henriheimann/urban-climate-monitor/README.md

# Urban Climate Monitor

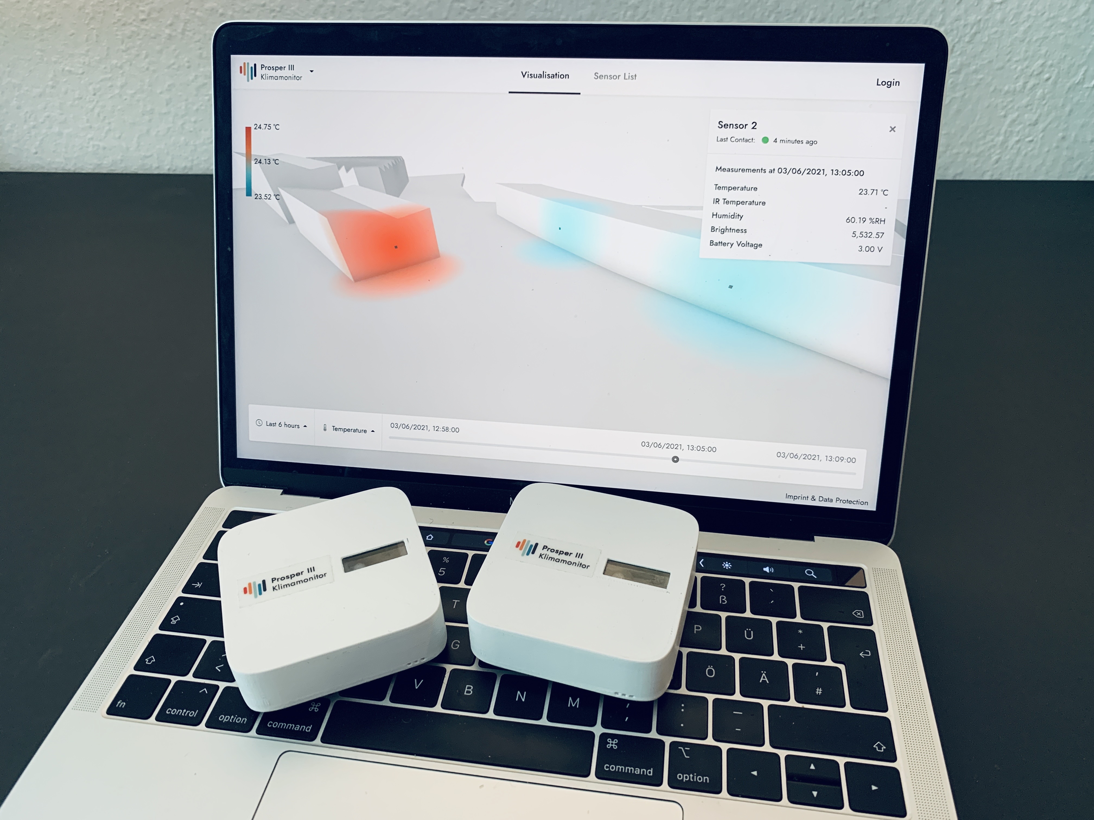
[picture p1: documentation/assets/promo.jpeg]
Promo


Documentation: https://henriheimann.github.io/urban-climate-monitor/
