henriheimann/urban-climate-monitor/documentation/hardware.adoc

=== Schematics

Sensor Node Schematic

=== Bill of Materials

[cols="~,~,~,~"]
|===
|Reference |Value |Manufacturer # |Comment
|AE1 | |ANT-868-CHP-T |Linx 868 Mhz Antenna
|BT1 | |2468 |Keystone 2xAAA battery holder
|C11 |4.7pF | |
|C12 |15pF | |
|C2 C4 C5 C6 C7 C8 C9 C10 C13 C14 C15 C16 |100nF | |
|C1 C3 |10uF | |
|D1 | |BPV10 |Vishay Photodiode
|FB1 | |742792040 |Wurth Elektronik Ferrite Bead
|J1 | |CONUFL001-SMD-T |Linx connector required only for antenna matching
|J2 | |SHF-105-01-L-D-TH |Samtec connector for SWD 2x5 1.27mm
|L1 |4.7uH | |
|Q1 | |PMV250EPEA |Nexpreia P-channel MOSFET
|R11 R12 |4.7k | |
|R13 |100 | |
|R5 R6 R7 R14 |10k | |
|R2 |330k | |
|R3 R4 R10 |100k | |
|R8 |1M | |
|R9 |33k | |
|U1 | |TLV61225DCKR |Texas Instruments voltage regulator
|U2 | |TPS27081ADDCR |Texas Instruments switch for reverse voltage protection
|U3 | |SHT31-DIS-F2.5kS |Sensirion temperature and humidity sensor
|U4 | |24LC32AT-I/SN |Microchip EEPROM
|U5 | |MLX90614ESF-BCC-000-TU |Optional Melexis IR temperature sensor
|U6 | |ADG633YRUZ |Analog Devices CMOS switch
|U7 | |TSV911RILT |STMicroelectronics operational amplifier
|U8 | |RFM95W-868 |HopeRF LoRA module
|U9 | |STM32L412KBT6 |STMicroelectronics microcontroller
| | |CSH-SGFB-100-UFFR |Additional equipment: Linx cable for antenna matching
| | |ADP-SMAM-SMAM-G |Additional equipment: Linx adapter for antenna matching

|===

=== Plots

[.clearfix]
--
[.left]
.Top
Top Plot

[.left]
.Bottom
Bottom Plot
--
