henriheimann/urban-climate-monitor/documentation/quickstart.adoc

=== The Things Network Setup

The system requires a The Things Network application. To do so create a TTN account and use the https://console.cloud.thethings.network/[TTN cloud console]. You will require the region, the id and the EUI of the application later. An access key with read and write privileges must also be generated and noted down. Lastly setup the decoder function for the created TTN application using the following Javascript code:

.TTN Payload Decoder Function
[source,javascript]
----
function decode_int16(byte_high, byte_low) {
  var int16 = ((byte_high << 8) | byte_low);
  if (int16 == 32767) {
    return null;
  } else {
    return int16 / 100.0;
  }
}

function Decoder(bytes, port) {
  var decoded = {};

  decoded.temperature = decode_int16(bytes[1], bytes[0]);
  decoded.humidity = decode_int16(bytes[3], bytes[2]);
  decoded.ir_temperature = decode_int16(bytes[5],  bytes[4]);
  decoded.brightness_current = (bytes[9] << 24) | (bytes[8] << 16) | (bytes[7] << 8) | bytes[6];
  decoded.battery_voltage = bytes[10] / 10.0;

  return decoded;
}
----

=== Development Environment

The setup of the local development environment requires quite a few steps. First and foremost, for Sensor Nodes to be able to actively communicate their measurements to the backend, they require a The Things Network gateway in LoRA communications range. A good gateway for getting started which is available for less than 100€ is the https://www.thethingsnetwork.org/docs/gateways/thethingsindoor/[TTN Indoor Gateway].

==== local-dev Deployment

To start the required services (PostgreSQL database, Telegraf and InfluxDB) to get the backend and frontend up and running use the local-dev deployment stage. Create an `.env` file using the following content, save it as `deployment/local-dev/.env` and execute `deployment/local-dev/deploy-local-dev.sh` afterwards:

.local-dev Deployment Example .env FIle
[source]
----
INFLUXDB_HOST=ucm-influxdb          # Used for inter-container connections, unreachable from host
INFLUXDB_PORT=8086
INFLUXDB_DB=metrics
INFLUXDB_TEST_DB=metricstest
INFLUXDB_ADMIN_USER=admin
INFLUXDB_ADMIN_PASSWORD=password    # For the setup of the local dev environment, use the worst password possible
INFLUXDB_USER=user
INFLUXDB_USER_PASSWORD=password

TELEGRAF_HOST=ucm-telegraf          # Used for inter-container connections, unreachable from host

TTN_REGION=                         # Fill using the values of your TTN app
TTN_APP_ID=                         # Fill using the values of your TTN app
TTN_APP_ACCESS_KEY=                 # Fill using the values of your TTN app

POSTGRES_HOST=::1                   # Used to access from the host machine
POSTGRES_PORT=5432
POSTGRES_USER=user
POSTGRES_PASSWORD=password
POSTGRES_DB=ucm
POSTGRES_TEST_DB=ucmtest
----

==== Backend

Environment variables:: Make sure to export the following environment variables or set them up in your IDE before starting the backend.

[cols="1,~,~"]
|===
|Variable |Value |Description 

|POSTGRES_HOST
|::1
|Host under which the backend can reach the PostgreSQL instance running.

|POSTGRES_PORT
|5432
|Port under which the backend can reach the PostgreSQL instance running.

|POSTGRES_DB
|ucm
|Name of the PostgreSQL database used.

|POSTGRES_USER
|user
|User to access the PostgreSQL database.

|POSTGRES_PASSWORD
|password
|Password to access the PostgreSQL database.

|INFLUXDB_HOST
|localhost
|Host under which the backend can reach the InfluxDB instance running, different from the internal host configured in the .env file!

|INFLUXDB_PORT
|8086
|Port under which the backend can reach the InfluxDB instance running.

|INFLUXDB_DB
|metrics
|Name of the InfluxDB database used.

|INFLUXDB_USER
|user
|User to access the InfluxDB database.

|INFLUXDB_USER_PASSWORD
|password
|Password to access the InfluxDB database.

|UCM_BACKEND_ADMIN_USERNAME
|admin
|The username of the default admin created when starting the backend.

|UCM_BACKEND_ADMIN_PASSWORD
|password
|The password of the default admin created when starting the backend.

|UCM_BACKEND_OAUTH_CLIENT_ID
|ucm-client
|The client used by the frontend when requesting tokens.

|UCM_BACKEND_OAUTH_CLIENT_SECRET
|secret
|The password used by the frontend when requesting tokens.

|TTN_REGION
|
|Region of your TTN app.

|TTN_APP_ID
|
|ID of your TTN app.

|TTN_APP_ACCESS_KEY
|
|Access key of your TTN app.

|TTN_APP_EUI
|
|EUI of your TTN app EUI.

|TTN_DEVICE_ID_PREFIX
|26011
|Different for all regions, for eu use 26011.

|DEPLOYMENT_URL
|http://locahost:4200
|The URL under which the frontend will be run, required for CORS configuration.

|===

Running the backend:: You can use maven to compile and run the backend using `mvn clean install` and `mvn spring-boot:run`.

==== Frontend

Environment variables:: Make sure to export the following environment variables before starting the frontend.

[cols="1,~,~"]
|===
|Variable |Value |Description 

|UCM_BACKEND_URL
|http://localhost:8080
|The url under which the frontend expects the backend.

|UCM_BACKEND_OAUTH_CLIENT_ID
|ucm-client
|The client used when requesting tokens.

|UCM_BACKEND_OAUTH_CLIENT_SECRET
|secret
|The password used when requesting tokens.

|UCM_FRONTEND_PRODUCTION
|false
|Only used to enable production builds.

|===

Running the frontend:: Install the required packages using `npm install` and run the frontend with `npm run start`. It should now accessible using the browser of your choice under http://localhost:4200.

=== Hardware Fabrication

Export Gerber files:: You can use KiCAD to export Geber files under File > Plot. Use the settings required by your manufacturer.
Fabrication:: The existing sensor nodes have been fabricated by https://aisler.net/[Aisler] as 'Beautiful Boards Budget' with a thickness of 1,6mm.
Assembly:: See <<Bill of Materials>> for a detailed list of all parts required for the assembly of a sensor node board. The surface mount components of the existing sensor nodes have been assembled using solder paste and a stencil manufactured also by Aisler. 

=== Embedded Software

Environment variables:: Make sure to export the following environment variables before proceeding. The values for these are unique per Sensor and can be obtained from the administration section of the frontend. For that purpose, create a new or view an existing sensor and click the Keys button under TTN Keys.

[cols="1,~,~"]
|===
|Variable |Example Value |Description 

| TTN_KEYS_DEVICE_ADDRESS
| {0x00, 0x00, 0x00, 0x00}
| Device address of this sensor

| TTN_KEYS_APPLICATION_SESSION_KEY
| {0x00, ..., 0x00}
| Key for accessing TTN, do not share!

| TTN_KEYS_NETWORK_SESSION_KEY
| {0x00, ..., 0x00}
| Key for accessing TTN, do not share!
|===

Prerequisites:: `cmake` and `gcc-arm-none-eabi` are required to build the embedded software.
Go to software directory:: `cd <project root>/software/embedded/sensor-node/`
Create build directory:: `cmake -E make_directory build && cd build`
Run CMake:: `cmake .. -DCMAKE_BUILD_TYPE=Release`
Run CMake build:: `cmake --build . --config Release`
Flash onto hardware:: Use the STM32 ST-Link utility to flash the created binary onto the microcontroller. You will need an ST-Link programmer and an adapter from your programmer to SWD (2x5 1.27mm) (for example https://www.adafruit.com/product/2094[this one] from Adafruit). For the first flashing of a brand new microcontroller, you may need to use ST-Link utility to disable the Option Byte `nBoost0_SW_Cfg`. For later flashings, you can use any other utility such as OpenOCD which can be directly done from your IDE.

=== Assembly

==== Required Parts

[cols="1,~"]
|===
|Count |Part

|1
|Fabricated and assembled Sensor Node PCB

|1
|3d-printed and painted case upper half

|1
|3d-printed and painted case lower half

|1
|Acrylic glass sheet with dimensions 1x3cm and a depth of no more than 1.5mm

|1
|Self-adhesive logo label 

|2
|2x M2 screws with a length of 6mm

|4
|4x M3 screws with a length of 16mm

|2
|2x AAA batteries

|===

.Overview of all Parts
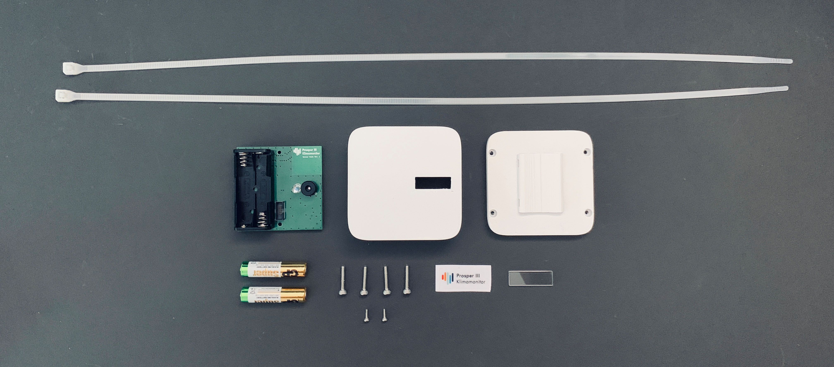
[picture p11: documentation/assets/parts-overview-cable-ties.jpeg]
Parts for Assembly


==== Assembly Steps

Add acrylic glass sheet:: Glue the acrylic glass sheet into the matching cutout of the upper half of the case from the inside.
Add logo:: Apply the self-adhesive logo sticker next to the cutout from the outside.
Mount PCB:: Screw the PCB onto the lower half of the case using the two M2 screws. You will need to apply a lot of pressure to force these into the 3d-printed screw holes.
Insert batteries:: If haven done so already, insert the two AAA batteries into the holder. You should have flashed the firmware and verified that sensor successfully communicates with TTN and the Urban Climate Monitor web solution by now. 
Close the case:: Place the lower half of the case in the upper half of the case and screw them together using the 4 M3 screws.
