henriheimann/urban-climate-monitor/documentation/assets/location_sensor_list.png

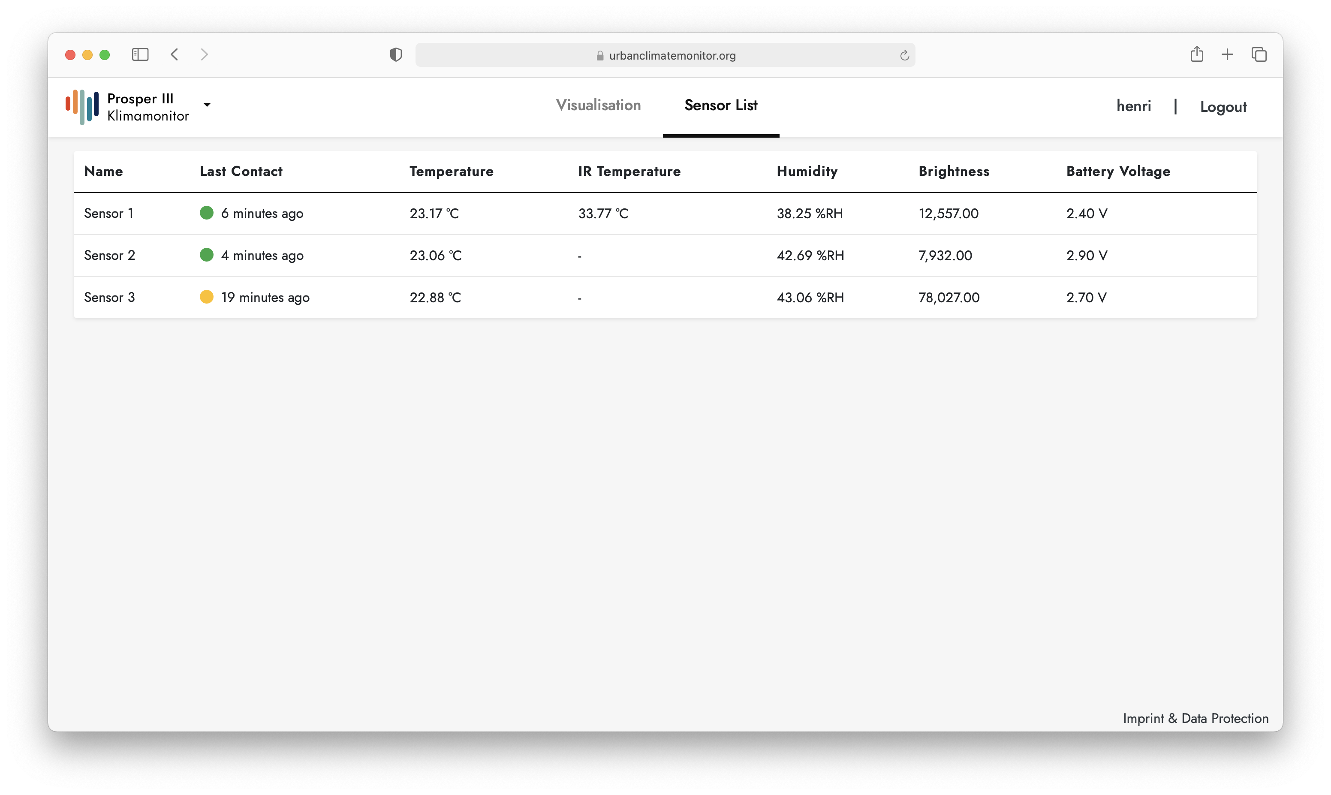
documentation/assets/location_sensor_list.png
