henriheimann/urban-climate-monitor/documentation/assets/three-sensors.jpeg

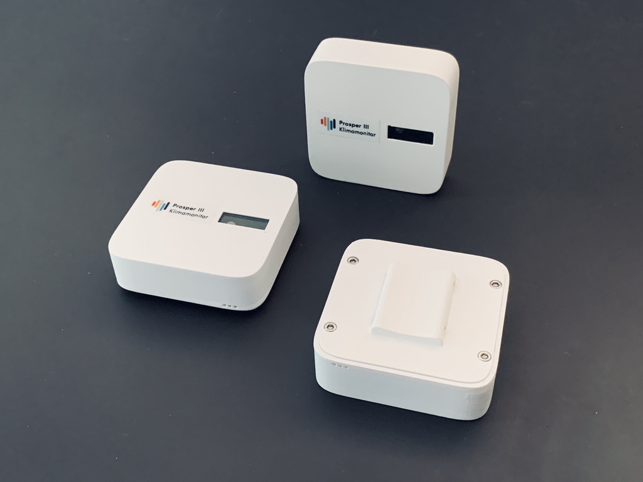
documentation/assets/three-sensors.jpeg
