henriheimann/urban-climate-monitor/hardware/sensor-node/bom.xlsx

 | Number of Boards: | 3
Source | Reference | Value | Quantity Abs | Quantity | Manufacturer # | Digikey # | Digikey STK | Mouser # | Mouser STK | Price
BOM | AE1 |  |  | 1 | ANT-868-CHP-T | ANT-868-CHP-TCT-ND | 2.32 € |  |  | 6.96 €
BOM | BT1 |  |  | 1 | 2468 |  |  | 534-2468 | 1.15 € | 3.45 €
BOM | C11 | 4.7pF |  | 1 | C0805C479C8HACTU |  |  | 80-C0805C479C8HACTU | 0.09 € | 0.26 €
BOM | C12 | 15pF |  | 1 | C0805C150M8HACTU |  |  | 80-C0805C150M8HACTU | 0.09 € | 0.26 €
BOM | C2 C4 C5 C6 C7 C8 C9 C10 C13 C14 C15 C16 | 100nF |  | 12 | C0805C103K8RACTU |  |  | 80-C0805C103K8R | 0.15 € | 5.47 €
BOM | C1 C3 | 10uF |  | 2 | C0805C106K9PAC7210 |  |  | 80-C0805C106K9P7210 | 0.12 € | 0.71 €
BOM | D1 |  |  | 1 | BPV10 |  |  | 782-BPV10 | 0.93 € | 2.80 €
BOM | FB1 |  |  | 1 | 742792040 |  |  | 710-742792040 | 0.19 € | 0.56 €
BOM | J1 |  |  | 1 | CONUFL001-SMD-T |  |  | 712-CONUFL001-SMD-T | 0.53 € | 1.58 €
BOM | J2 |  |  | 1 | SHF-105-01-L-D-TH |  |  | 200-SHF10501LDTH | 2.29 € | 6.87 €
BOM | L1 | 4.7uH |  | 1 | SRN4018TA-4R7M | SRN4018TA-4R7MCT-ND | 0.41 € |  |  | 1.23 €
BOM | Q1 |  |  | 1 | PMV250EPEA |  |  | 771-PMV250EPEAR | 0.34 € | 1.02 €
BOM | R11 R12 | 4.7k |  | 2 | RC0805FR-074K7L |  |  | 603-RC0805FR-074K7L | 0.11 € | 0.66 €
BOM | R13 | 100 |  | 1 | RC0805FR-07100RL |  |  | 603-RC0805FR-07100RL | 0.11 € | 0.33 €
BOM | R5 R6 R7 R14 | 10k |  | 4 | RC0805FR-0710KL |  |  | 603-RC0805FR-0710KL | 0.11 € | 1.32 €
BOM | R2 | 330k |  | 1 | RC0805FR-07330KL |  |  | 603-RC0805FR-07330KL | 0.11 € | 0.33 €
BOM | R3 R4 R10 | 100k |  | 3 | RC0805FR-07100KL |  |  | 603-RC0805FR-07100KL | 0.11 € | 0.99 €
BOM | R8 | 1M |  | 1 | RC0805FR-071ML |  |  | 603-RC0805FR-071ML | 0.09 € | 0.26 €
BOM | R9 | 33k |  | 1 | RC0805FR-0733KL |  |  | 603-RC0805FR-0733KL | 0.11 € | 0.33 €
BOM | U1 |  |  | 1 | TLV61225DCKR |  |  | 595-TLV61225DCKR | 0.86 € | 2.58 €
BOM | U2 |  |  | 1 | TPS27081ADDCR |  |  | 595-TPS27081ADDCR | 0.66 € | 1.98 €
BOM | U3 |  |  | 1 | SHT31-DIS-F2.5kS |  |  | 403-SHT31-DIS-F | 5.40 € | 16.20 €
BOM | U4 |  |  | 1 | 24LC32AT-I/SN |  |  | 579-24LC32AT-I/SN | 0.29 € | 0.86 €
BOM | U5 |  |  | 1 | MLX90614ESF-BCC-000-TU | MLX90614ESF-BCC-000-TU-ND | 20.78 € |  |  | 62.34 €
BOM | U6 |  |  | 1 | ADG633YRUZ |  |  | 584-ADG633YRUZ | 2.24 € | 6.72 €
BOM | U7 |  |  | 1 | TSV911RILT |  |  | 511-TSV911RILT | 0.63 € | 1.89 €
BOM | U8 |  |  | 1 | RFM95W-868 | RFM95W-868S2-ND | 12.20 € |  |  | 36.60 €
BOM | U9 |  |  | 1 | STM32L412KBT6 |  |  | 511-STM32L412KBT6 | 3.06 € | 9.18 €
EQUIP |  |  | 1 |  | CSH-SGFB-100-UFFR |  |  | 712-CSH-SGFB100-UFFR | 4.87 € | 4.87 €
EQUIP |  |  | 1 |  | ADP-SMAM-SMAM-G |  |  | 712-ADP-SMAM-SMAM-G | 5.52 € | 5.52 €
 |  |  |  |  |  |  |  |  |  | 184.11 €
