henriheimann/urban-climate-monitor/documentation/assets/parts-overview.jpeg

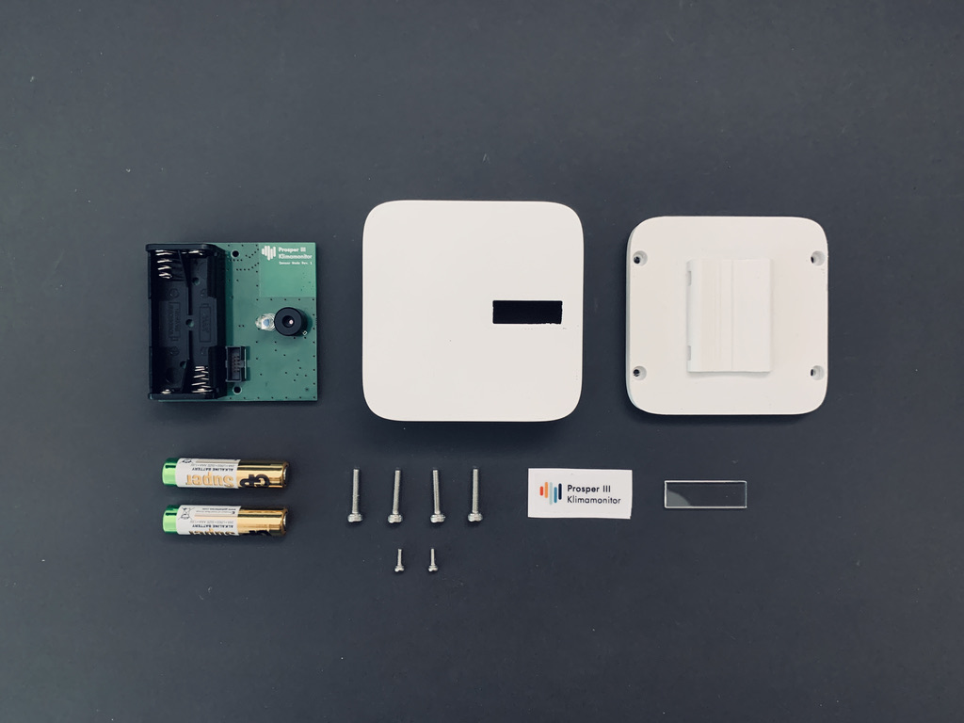
documentation/assets/parts-overview.jpeg
