henriheimann/urban-climate-monitor/design/prosperIII.obj

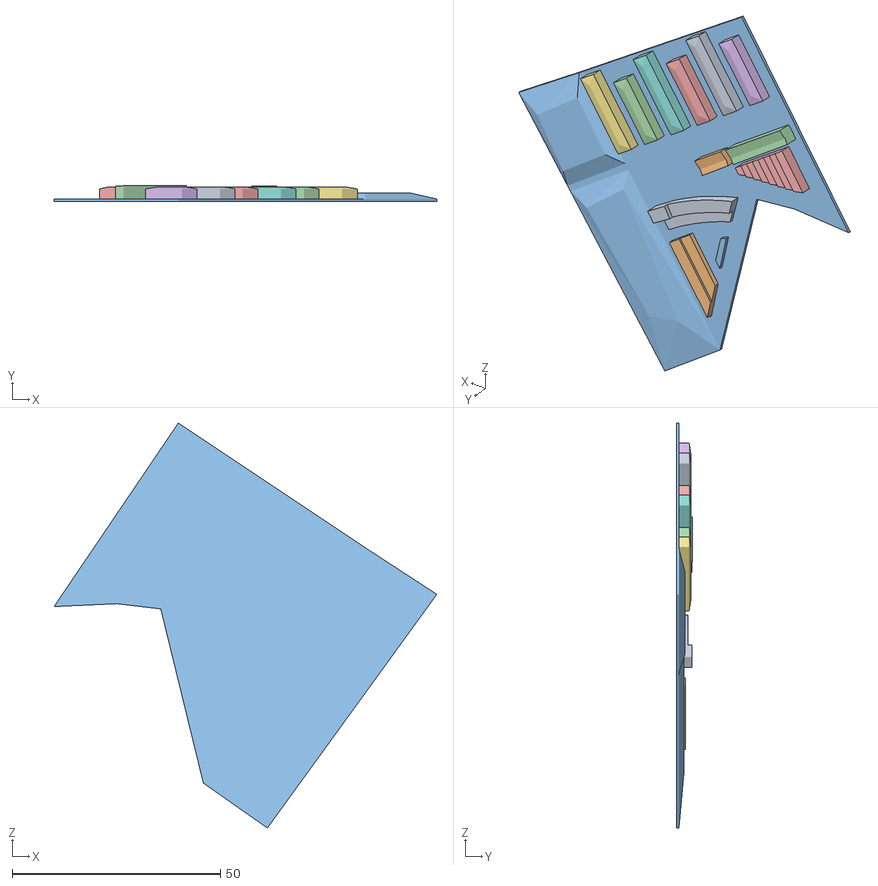
[picture p15: CAD file, 2021-05-31]
design/prosperIII.obj
92.0 x 3.91 x 97.3
Cube_Cube.001
Cube.001_Cube.002
Cube.002_Cube.003
Cube.003_Cube.004
Cube.004_Cube.005
Cube.005_Cube.006
Cube.006_Cube.008
Cube.007_Cube.009
Cube.008_Cube.010
Cube.009_Cube.011
Cube.010_Cube.012
Cube.011_Cube.013
Cube.012_Cube.014
