henriheimann/urban-climate-monitor/software/backend/src/test/resources/uploads/models/cube.obj

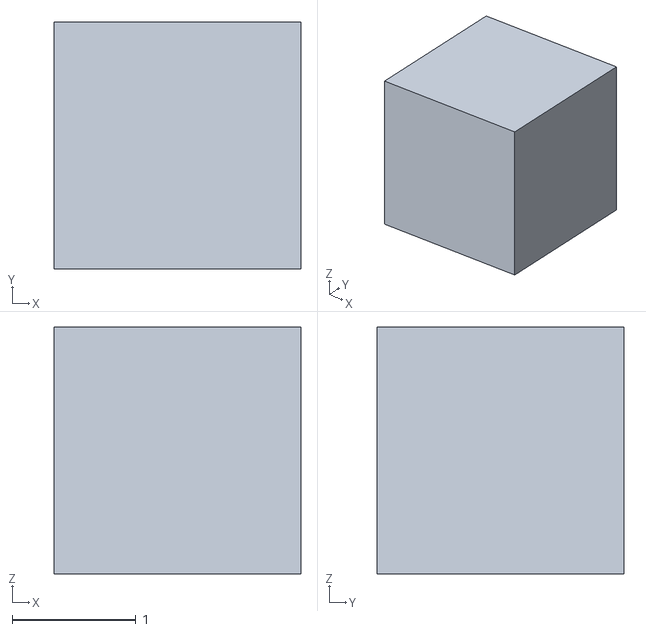
[picture p16: CAD file, 2021-04-15]
software/backend/src/test/resources/uploads/models/cube.obj
2.00 x 2.00 x 2.00
