henriheimann/urban-climate-monitor/(list of files, cad)

Other CAD files:
software/backend/src/test/resources/uploads/models/cube2.obj
design/prosperIII.blend
