henriheimann/urban-climate-monitor/design/logo-print.pdf

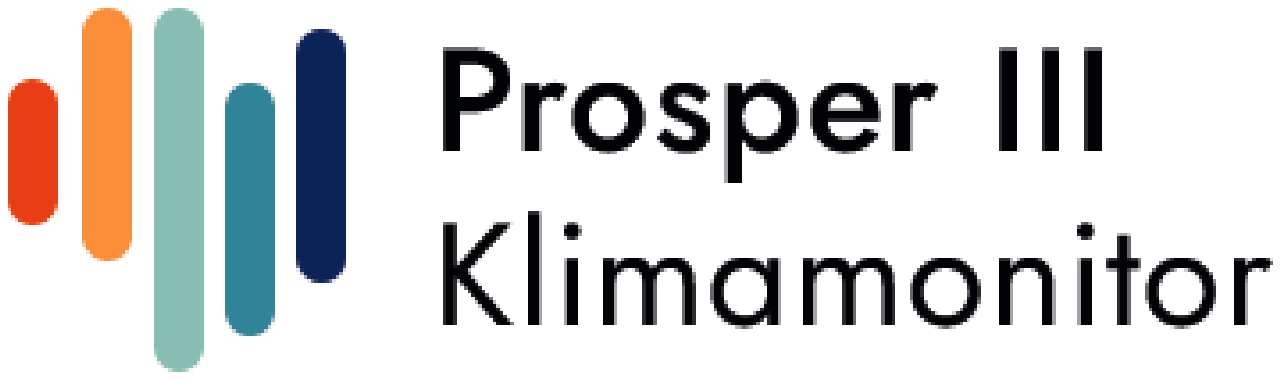
[picture p17: page 1]
