henriheimann/urban-climate-monitor/hardware/sensor-node/sensor-node.kicad_pcb

## KiCad design hardware/sensor-node/sensor-node.kicad_pcb (2021-04-15)

Schematic: sensor-node.sch, Urban Climate Monitor Sensor Node

Parts:
AE1: ANT-868-CHP-T; Linx_ANT-868-CHP-T; mouser# 712-ANT-868-CHP-T; digikey# ANT-868-CHP-TCT-ND
BT1: Keystone-2468; BatteryHolder_Keystone_2468_2xAAA_NoSilkscreen; mouser# 534-2468; digikey# 36-2468-ND
C1, C3: 10uF; C_0805_2012Metric_Pad1.18x1.45mm_HandSolder; mouser# 80-C0805C106K9P7210; digikey# 399-C0805C106K9PAC7210CT-ND
C2, C4, C5, C6, C7, C8, C9, C10, C13, C14, C15, C16: 100nF; C_0805_2012Metric_Pad1.18x1.45mm_HandSolder; mouser# 80-C0805C103K8R; digikey# C0805C103K8RAC7800
C11: 4.7pF; C_0805_2012Metric_Pad1.18x1.45mm_HandSolder; mouser# 80-C0805C479C8HACTU; digikey# C0805C479C8HAC7800-ND
C12: 15pF; C_0805_2012Metric_Pad1.18x1.45mm_HandSolder; mouser# 80-C0805C150M8HACTU; digikey# C0805C150M8HAC7800
D1: BPV10; LED_D5.0mm_Clear; mouser# 782-BPV10; digikey# 751-1001-ND
FB1: WE742792040; L_0805_2012Metric_Pad1.15x1.40mm_HandSolder; mouser# 710-742792040; digikey# 732-1620-1-ND
H1, H2: MountingHole; MountingHole_2.2mm_M2
J1: CONUFL001-SMD-T; CONUFL001-SMD; mouser# 712-CONUFL001-SMD-T; digikey# CONUFL001-SMD-TCT-ND
J2: SHF-105-01-L-D-TH; mouser# 200-SHF10501LDTH; digikey# SAM11769-ND
L1: 4.7uH; L_Bourns-SRN4018_With3DModel; mouser# 652-SRN4018TA-4R7M; digikey# SRN4018TA-4R7MTR-ND
Q1: PMV250EPEA; SOT-23; mouser# 771-PMV250EPEAR; digikey# 1727-2303-1-ND
R1, R6: 100k; R_0805_2012Metric_Pad1.20x1.40mm_HandSolder; mouser# 603-RC0805FR-0710KL; digikey# 311-10.0KCRCT-ND
R2: 330k; R_0805_2012Metric_Pad1.20x1.40mm_HandSolder; mouser# 603-RC0805FR-07330KL; digikey# 311-330KCRCT-ND
R3, R10: 100k; R_0805_2012Metric_Pad1.20x1.40mm_HandSolder; mouser# 603-RC0805FR-07100KL; digikey# 311-100KCRCT-ND
R5, R7, R14: 10k; R_0805_2012Metric_Pad1.20x1.40mm_HandSolder; mouser# 603-RC0805FR-0710KL; digikey# 311-10.0KCRCT-ND
R8: 1M; R_0805_2012Metric_Pad1.20x1.40mm_HandSolder; mouser# 603-RC0805FR-071ML; digikey# 311-1.00MCRCT-ND
R9: 33k; R_0805_2012Metric_Pad1.20x1.40mm_HandSolder; mouser# 603-RC0805FR-0733KL; digikey# 311-33.0KCRCT-ND
R11, R12: 4.7k; R_0805_2012Metric_Pad1.20x1.40mm_HandSolder; mouser# 603-RC0805FR-074K7L; digikey# 311-4.70KCRCT-ND
R13: 100; R_0805_2012Metric_Pad1.15x1.40mm_HandSolder; mouser# 603-RC0805FR-07100RL; digikey# 311-100CRCT-ND
U1: TLV61225; SC-70-6; mouser# 595-TLV61225DCKR; digikey# 296-36756-1-ND
U2: TPS27081A; TSOT-23-6; mouser# 595-TPS27081ADDCR; digikey# 296-34970-1-ND
U3: SHT31-DIS; Sensirion_DFN-8-1EP_2.5x2.5mm_P0.5mm_EP1.1x1.7mm; mouser# 403-SHT31-DIS-F; digikey# 1649-1066-1-ND
U4: 24LC32; SOIC-8_3.9x4.9mm_P1.27mm; mouser# 579-24LC32AT-I/SN; digikey# 24LC32AT-I/SNCT-ND
U5: MLX90614; TO-39-4; mouser# 482-90614ESFBCC000TU; digikey# MLX90614ESF-BCC-000-TU-ND
U6: ADG633YRU; TSSOP-16_4.4x5mm_P0.65mm; mouser# 584-ADG633YRUZ; digikey# ADG633YRUZ-ND
U7: TSV911RILT; SOT-23-5; mouser# 511-TSV911RILT; digikey# 497-10538-1-ND
U8: RFM95W; mouser# 223-RFM95W-868S2; digikey# RFM95W-868S2-ND
U9: STM32L412KB; LQFP-32_7x7mm_P0.8mm; mouser# 511-STM32L412KBT6; digikey# 497-18229-ND
Z1, Z2, Z3: Z; R_0805_2012Metric_Pad1.20x1.40mm_HandSolder

Connections:
+3.3VA: C13.1, FB1.2, U9.5 (VDDA)
+3V3: C1.1, C8.1, C10.1, C14.1, C15.1, FB1.1, J2.1 (VTref), Q1.2 (S), R3.1, R10.2, U1.2 (FB), U1.4 (VOUT), U6.14, U6.16, U8.13 (VCC), U9.1 (VDD), U9.17 (VDD)
/PHOTO_VCC: C6.1, R2.2, U6.13, U7.2 (V+)
GND: BT1.2 (-), C1.2, C2.2, C3.2, C4.2, C5.2, C6.2, C7.2, C8.2, C9.2, C10.2, C13.2, C14.2, C15.2, C16.2, D1.2 (A), J1.2 (Ext), J2.3 (GND), J2.5 (GND), J2.9 (GNDDetect), R1.1, R6.1, R7.1, R14.2, U1.3 (GND), U2.1 (R2), U2.5 (ON/OFF), U2.6 (R1,C1), U3.2 (ADDR), U3.7 (R), U3.8 (VSS), U3.9 (VSS), U4.1 (A0), U4.2 (A1), U4.3 (A2), U4.4 (GND), U4.7 (WP), U5.4 (VSS), U6.6, U6.7, U6.8, U7.5 (V-), U8.1 (GND), U8.8 (GND), U8.10 (GND), U9.16 (VSS), U9.32 (VSS), Z1.2, Z3.1
I2C_ENABLE: Q1.1 (G), R10.1, U9.28 (PB5)
MISO: U8.2 (MISO), U9.12 (PA6)
MOSI: U8.3 (MOSI), U9.13 (PA7)
NRST: C16.1, J2.10 (~RESET~), U9.4 (NRST)
unnamed: AE1.1, Z2.2, Z3.2
unnamed: BT1.1 (+), U2.2 (VOUT), U2.3 (VOUT)
unnamed: C7.1, R2.1, R7.2, U7.3 (+)
unnamed: C11.1, C12.1, D1.1 (K), R8.1, R9.1, U7.4 (-)
unnamed: C11.2, R8.2, U6.2, U6.5
unnamed: C12.2, R9.2, U6.1, U6.3
unnamed: J1.1 (In), U8.9 (ANT), Z1.1, Z2.1
unnamed: L1.1, U1.5 (L)
unnamed: R5.2, U6.4
unnamed: R13.2, U9.6 (PA0)
unnamed: R14.1, U9.31 (PH3)
unnamed: U6.15, U7.1
PHOTO_ENABLE: R6.2, U6.11, U9.21 (PA11)
PHOTO_SENSE: C9.1, R5.1, U9.15 (PB1)
PHOTO_SWITCH: R1.2, U6.9, U6.10, U9.22 (PA12)
RFM95_DIO5: U8.7 (DIO5), U9.8 (PA2)
RFM95_IRQ: U8.14 (DIO0), U9.14 (PB0)
RFM95_NRST: R3.2, U8.6 (RESET), U9.9 (PA3)
RFM95_NSS: U8.5 (~SS), U9.10 (PA4)
SCK: U8.4 (SCK), U9.11 (PA5)
SCL: R11.2, U3.4 (SCL), U4.6 (SCL), U5.1 (SCL), U9.29 (PB6)
SDA: R12.2, U3.1 (SDA), U4.5 (SDA), U5.2 (SDA), U9.30 (PB7)
SWCLK: J2.4 (SWDCLK/TCK), U9.24 (PA14)
SWDIO: J2.2 (SWDIO/TMS), U9.23 (PA13)
VI2C: C2.1, C4.1, C5.1, Q1.3 (D), R11.1, R12.1, U3.5 (VDD), U4.8 (VCC), U5.3 (VDD)
VIN_SENSE: C3.1, L1.2, R13.1, U1.1 (VIN), U1.6 (EN), U2.4 (VIN)

Notes on the sheet:
Reverse Polarity Protection
Boost Converter
SWD Connector
STM32L4 MCU
I2C-Address: 0x44
I2C-Address: 0x5a
Offset: 3.3V*1/(33+1)=97mV
Infrared Temperature Sensor (optional)
Temperature / Humidity Sensor
LoRA Module
Light Sensor
I2C-Address: 0x50
EEPROM
5000nA Sleep
200nA Sleep
5000nA Standby
245nA Standby with RTC
10nA when disabled
160Hz low pass
I2C Bus Control

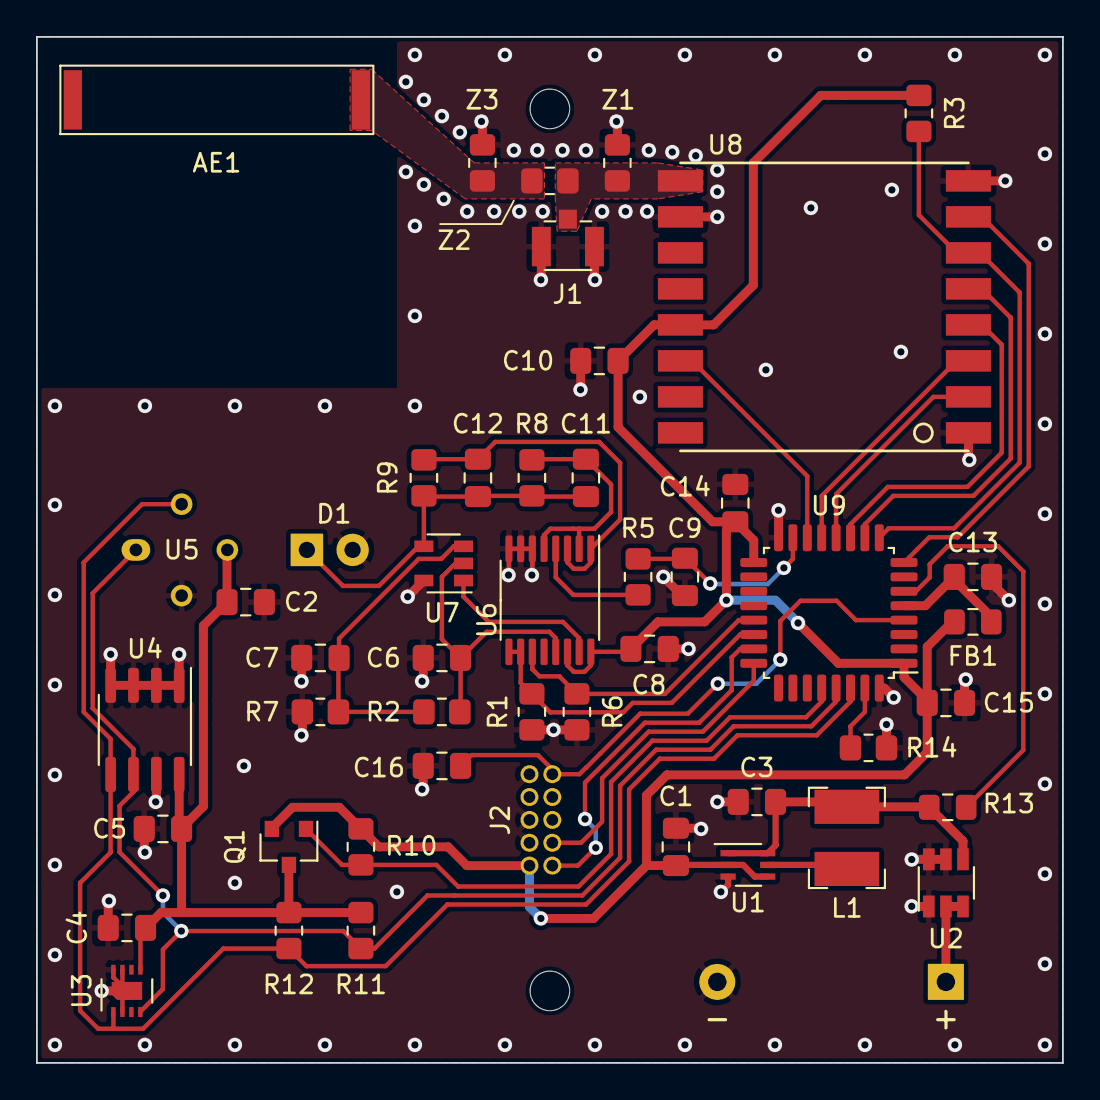
[picture p18: board sensor-node.kicad_pcb from above]

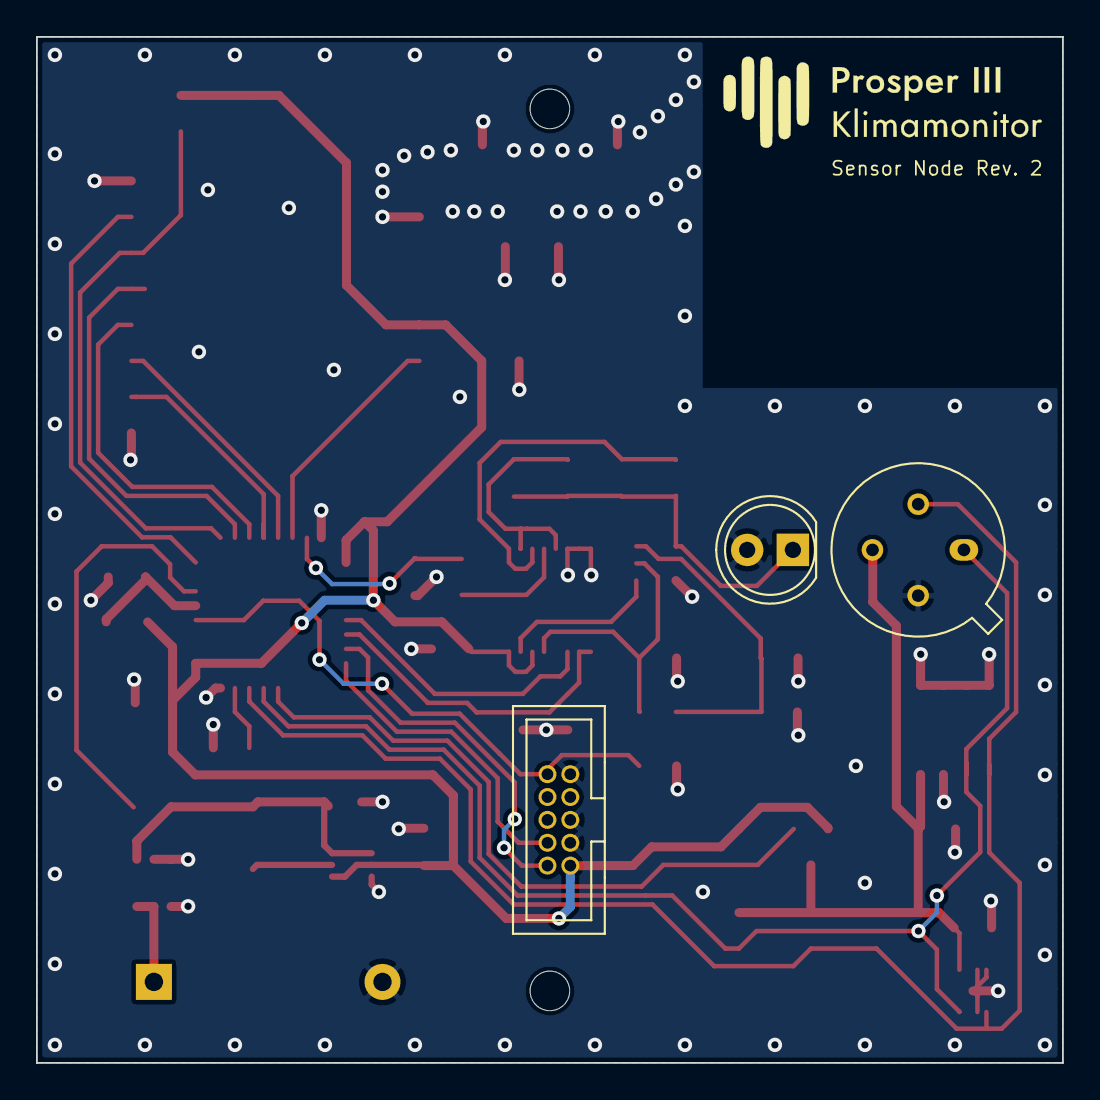
[picture p19: board sensor-node.kicad_pcb from below]

Board: 2 copper layers, 57.0 x 57.0 mm, 51 parts (4 on the bottom side), 34 nets.
