henriheimann/urban-climate-monitor/Hardware/SensorNode/urban-climate-monitor.sch

## KiCad design Hardware/SensorNode/urban-climate-monitor.sch (2020-11-11)

Schematic: urban-climate-monitor.sch

Parts:
AE1: Antenna; 868MHZ_TI_DNO24
BT1: Battery; BatteryHolder_Keystone_2468_2xAAA_NoSilkscreen
C1, C3: 4.7uF; C_0805_2012Metric_Pad1.18x1.45mm_HandSolder
C2, C4, C5, C6, C7, C8, C9, C10, C13, C14, C15, C16: 100nF; C_0805_2012Metric_Pad1.18x1.45mm_HandSolder
C11: 4.7pF; C_0805_2012Metric_Pad1.18x1.45mm_HandSolder
C12: 15pF; C_0805_2012Metric_Pad1.18x1.45mm_HandSolder
D1: D_Photo; LED_D5.0mm_Clear
FB1: Ferrite_Bead_Small; L_0805_2012Metric_Pad1.05x1.20mm_HandSolder
H1, H2: MountingHole; MountingHole_2.2mm_M2
J1: Conn_ARM_JTAG_SWD_10; Amphenol_FCI_ShroudedSocket_2x05_P1.27mm_Vertical_SMD
L1: 4.7uH; L_Bourns-SRN4018_With3DModel
R1, R8: 1M; R_0805_2012Metric_Pad1.20x1.40mm_HandSolder
R2: 330k; R_0805_2012Metric_Pad1.20x1.40mm_HandSolder
R3, R4: 100k; R_0805_2012Metric_Pad1.20x1.40mm_HandSolder
R5, R6, R7, R12: 10k; R_0805_2012Metric_Pad1.20x1.40mm_HandSolder
R9: 33k; R_0805_2012Metric_Pad1.20x1.40mm_HandSolder
R10, R11: 4.7k; R_0805_2012Metric_Pad1.20x1.40mm_HandSolder
U1: AAT1217; TSOT-23-6_HandSoldering
U2: TPS27081A; TSOT-23-6_HandSoldering
U3: SHT31-DIS; Sensirion_DFN-8-1EP_2.5x2.5mm_P0.5mm_EP1.1x1.7mm
U4: 24LC32; SOIC-8_3.9x4.9mm_P1.27mm
U5: TSD305
U6: ADG633YCP; TSSOP-16_4.4x5mm_P0.65mm
U7: TSV911RILT; SOT-23-5
U8: RFM95W
U9: STM32L412KB; LQFP-32_7x7mm_P0.8mm
Z1, Z2, Z3: Z; R_0805_2012Metric_Pad1.20x1.40mm_HandSolder

Notes on the sheet:
Reverse Polarity Protection
Boost Converter
SWD Connector
STM32L4 MCU
I2C-Address: 0x44
I2C-Address: 0x00
Offset: 3.3V*1/(33+1)=97mV
Infrared Temperature Sensor (optional)
Temperature / Humidity Sensor
LoRA Module
Light Sensor
I2C-Address: 0x50
EEPROM
20nA Sleep
200nA Sleep
10nA Standby
245nA Standby with RTC
10nA when disabled
160Hz low pass
