henriheimann/urban-climate-monitor/software/embedded/Core/Src/main.c

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
/* Includes ------------------------------------------------------------------*/
#include "main.h"
#include "adc.h"
#include "i2c.h"
#include "rtc.h"
#include "spi.h"
#include "gpio.h"

/* USER CODE BEGIN Includes */
#include "application.h"
/* USER CODE END Includes */


void SystemClock_Config(void);
/**
  * @brief  The application entry point.
  * @retval int
  */
int main(void)
{
  /* MCU Configuration--------------------------------------------------------*/

  /* Reset of all peripherals, Initializes the Flash interface and the Systick. */
  HAL_Init();

  /* Configure the system clock */
  SystemClock_Config();

  /* USER CODE BEGIN SysInit */
  // Check and handle if the system was resumed from StandBy mode */
  if(__HAL_PWR_GET_FLAG(PWR_FLAG_SB) != RESET)
  {
  	// Clear Standby flag
  	__HAL_PWR_CLEAR_FLAG(PWR_FLAG_SB);
  }
  /* USER CODE END SysInit */

  /* Initialize all configured peripherals */
  MX_GPIO_Init();
  MX_I2C1_Init();
  MX_ADC1_Init();
  MX_RTC_Init();
  MX_SPI1_Init();
  /* USER CODE BEGIN 2 */

  application_main();

  HAL_PWREx_EnableGPIOPullDown(PWR_GPIO_A, PWR_GPIO_BIT_12); // PHOTO_SWITCH
  HAL_PWREx_EnableGPIOPullDown(PWR_GPIO_A, PWR_GPIO_BIT_7); // MOSI
  HAL_PWREx_EnableGPIOPullDown(PWR_GPIO_A, PWR_GPIO_BIT_5); // SCK
  HAL_PWREx_EnableGPIOPullUp(PWR_GPIO_A, PWR_GPIO_BIT_3); // NRST
  HAL_PWREx_EnableGPIOPullDown(PWR_GPIO_A, PWR_GPIO_BIT_4); // NSS
  HAL_PWREx_EnablePullUpPullDownConfig();
  HAL_PWREx_DisableSRAM2ContentRetention();
  HAL_PWREx_EnableBORPVD_ULP();

  // Disable all used wakeup sources
  HAL_RTCEx_DeactivateWakeUpTimer(&hrtc);

  // Clear all related wakeup flags
  __HAL_PWR_CLEAR_FLAG(PWR_FLAG_WU);

  // Setting the Wake up time 1s * 0x0E10 = 1h
  // 10min = 0x0258
  // 10 sec = 0x000a
  HAL_RTCEx_SetWakeUpTimer_IT(&hrtc, 0x0258, RTC_WAKEUPCLOCK_CK_SPRE_16BITS, 0);

  // Enter the Standby mode
  HAL_PWR_EnterSTANDBYMode();

  /* USER CODE END 2 */

  /* Infinite loop */
  /* USER CODE BEGIN WHILE */
  while (1)
  {
    /* USER CODE END WHILE */

    /* USER CODE BEGIN 3 */
  }
  /* USER CODE END 3 */
}

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
