henriheimann/urban-climate-monitor/software/embedded/Core/Inc/main.h

#define VIN_SENSE_Pin GPIO_PIN_0
#define VIN_SENSE_GPIO_Port GPIOA
#define RFM95_DIO5_Pin GPIO_PIN_2
#define RFM95_DIO5_GPIO_Port GPIOA
#define RFM95_NRST_Pin GPIO_PIN_3
#define RFM95_NRST_GPIO_Port GPIOA
#define RFM95_NSS_Pin GPIO_PIN_4
#define RFM95_NSS_GPIO_Port GPIOA
#define RFM95_DIO0_Pin GPIO_PIN_0
#define RFM95_DIO0_GPIO_Port GPIOB
#define PHOTO_SENSE_Pin GPIO_PIN_1
#define PHOTO_SENSE_GPIO_Port GPIOB
#define PHOTO_ENABLE_Pin GPIO_PIN_11
#define PHOTO_ENABLE_GPIO_Port GPIOA
#define PHOTO_SWITCH_Pin GPIO_PIN_12
#define PHOTO_SWITCH_GPIO_Port GPIOA
#define SWDIO_Pin GPIO_PIN_13
#define SWDIO_GPIO_Port GPIOA
#define SWCLK_Pin GPIO_PIN_14
#define SWCLK_GPIO_Port GPIOA
#define I2C_ENABLE_Pin GPIO_PIN_5
#define I2C_ENABLE_GPIO_Port GPIOB
