henriheimann/urban-climate-monitor/software/backend/src/main/java/org/urbanclimatemonitor/backend/security/WebSecurityConfiguration.java

package org.urbanclimatemonitor.backend.security;

import org.springframework.context.annotation.Bean;
import org.springframework.context.annotation.Configuration;
import org.springframework.security.authentication.AuthenticationManager;
import org.springframework.security.authentication.AuthenticationProvider;
import org.springframework.security.authentication.dao.DaoAuthenticationProvider;
import org.springframework.security.config.annotation.web.configuration.EnableWebSecurity;
import org.springframework.security.config.annotation.web.configuration.WebSecurityConfigurerAdapter;
import org.springframework.security.core.userdetails.UserDetailsService;
import org.springframework.security.crypto.bcrypt.BCryptPasswordEncoder;
import org.springframework.security.crypto.password.PasswordEncoder;

@Configuration
@EnableWebSecurity
public class WebSecurityConfiguration extends WebSecurityConfigurerAdapter
{
	private final UserDetailsService userDetailsService;

	public WebSecurityConfiguration(CustomUserDetailsService userDetailsService)
	{
		this.userDetailsService = userDetailsService;
	}

	@Bean
	public AuthenticationProvider authenticationProvider()
	{
		DaoAuthenticationProvider provider = new DaoAuthenticationProvider();
		provider.setPasswordEncoder(passwordEncoder());
		provider.setUserDetailsService(userDetailsService);
		return provider;
	}

	@Bean
	public PasswordEncoder passwordEncoder()
	{
		return new BCryptPasswordEncoder();
	}

	@Bean
	@Override
	public AuthenticationManager authenticationManagerBean() throws Exception
	{
		return super.authenticationManagerBean();
	}
}
