henriheimann/urban-climate-monitor/(commit log)

2020-10-19 Add initial embedded software version and update schematic
    [urban-climate-monitor.kicad_pcb, urban-climate-monitor.sch]
2020-10-23 Update prototype pin assignment
    [urban-climate-monitor.sch]
2020-10-23 Add required submodules to prototype project
2020-10-26 Remove rfm9x submodule, sht3x test in main application
    [urban-climate-monitor.sch]
2020-10-26 Rename prototype project to PrototypeNode
2020-10-30 Add lora frame couting via eeprom
2020-10-30 Include EEPROM in schematic
    [urban-climate-monitor.sch]
2020-10-30 Add photo sensing implementation
    [urban-climate-monitor.sch]
2020-11-02 Create first revision of PCB, add CubeMX project for PCB sensor node
    [urban-climate-monitor.kicad_pcb, urban-climate-monitor.sch]
2020-11-02 Update directory structure
    [urban-climate-monitor.kicad_pcb, urban-climate-monitor.sch]
2020-11-03 Test KiCad action docs generation
2020-11-03 Trigger pipeline
    [urban-climate-monitor.sch]
2020-11-03 Fix warnings of electrical rules check
    [urban-climate-monitor.kicad_pcb, urban-climate-monitor.sch]
2020-11-11 Add photo enable pin, add deployment compose
    [urban-climate-monitor.kicad_pcb, urban-climate-monitor.sch]
2020-11-11 Upload only pdfs as artifact
    [urban-climate-monitor.kicad_pcb, urban-climate-monitor.sch]
2020-11-15 Change folder layout, add new version pcb layout
    [sensor-node.kicad_pcb, sensor-node.sch, urban-climate-monitor.kicad_pcb]
2020-11-15 Fix folder capitalisation
    [sensor-node.kicad_pcb, sensor-node.sch]
2020-11-15 Try fix folder capitalisation again part 1
    [application.c, application.h, main.c, main.h]
2020-11-15 Try fix folder capitalisation again part 2
    [application.c, application.h, main.c, main.h]
2020-11-15 Try fix submodules part 1
    [application.c, application.h, main.c, main.h]
2020-11-19 Update schema to include I2C voltage switching
    [sensor-node.sch]
2020-11-19 Update PCB, add debugging printouts to application
    [sensor-node.kicad_pcb, sensor-node.sch]
2020-11-19 Test export of board plot
    [sensor-node.sch]
2020-11-19 Fix workflow schematic and board references
    [sensor-node.sch]
2020-11-19 Only upload required files
    [sensor-node.sch]
2020-11-20 Fix timeouts for systick overflow handling
    [sensor-node.kicad_pcb, sensor-node.sch]
2020-11-21 Update PCB for enclosure
    [sensor-node.kicad_pcb, sensor-node.sch]
2020-11-22 Add 3d model to infrared temperature sensor
    [sensor-node.kicad_pcb]
2020-11-22 Add design resources and logo to PCB silkscreen
    [sensor-node.kicad_pcb]
2020-11-28 Add picket fence vias
    [sensor-node.kicad_pcb]
2020-11-29 Switch to available boost converter
    [sensor-node.kicad_pcb, sensor-node.sch]
2020-11-29 Update PCB for new boost converter
    [sensor-node.kicad_pcb]
2020-11-29 Fix ERC & DRC errors
    [sensor-node.kicad_pcb, sensor-node.sch]
2020-11-29 Fix ADG633YRU pinout
    [sensor-node.kicad_pcb, sensor-node.sch]
2020-11-29 Update C9 pad 2
    [sensor-node.kicad_pcb]
2020-11-29 Perform parts pinout check
    [sensor-node.kicad_pcb, sensor-node.sch]
2020-11-29 Add BOM excel sheet
    [bom.xlsx]
2020-12-28 Setup sensor-node embedded project
2020-12-28 Add sensor-node build workflow
2020-12-31 First implementation of MLX90614 driver
2021-01-09 Work on sensor-node application
2021-01-11 Fix rounding and wait for MLX90614
    [application.c]
2021-01-11 Fix PCB problems for Rev. 2
    [sensor-node.kicad_pcb, sensor-node.sch]
2021-01-11 Move Via
    [sensor-node.kicad_pcb]
2021-01-25 Add nanovna calibration
2021-03-22 Work on user and sensor controllers and services
2021-03-23 Add SensorService unit tests
2021-03-23 Remove prototype embedded software
2021-03-23 Move embedded software back to subfolder
    * Add stm32l4.cfg for OpenOCD
    * Source TTN keys from environment when using CMake
    [stm32l4.cfg]
2021-03-23 Don’t log maven transfer progress
2021-03-27 Add location controller and service
    [cube.obj]
2021-04-15 Complete admin UI in frontend, update workflows and deployment structure
    [cube.obj, stm32l4.cfg]
2021-04-15 Update workflows for documentation
    [sensor-node.kicad_pcb, sensor-node.sch]
2021-04-15 Force pipeline runs
    [sensor-node.sch]
2021-04-15 Update to kicad-exports@v2.2
    [sensor-node.sch]
2021-04-15 Fix repo path in hardware pipeline
    [sensor-node.sch]
2021-04-15 Fix kibot config paths
    [sensor-node.sch]
2021-04-15 Add custom pcb plot style
    [sensor-node.sch]
2021-04-25 Show TTN device keys in frontend
2021-04-26 Seperate local dev and test deployments, fix TTN device ID generation
    [sensor-node.sch]
2021-04-30 Implement location sensor list
2021-05-09 Cleanup frontend code, switch to eslint and prettier
2021-05-10 Refactor location entity logic, no longer use JWT token, finish edit sensors logic
    [cube2.obj]
2021-05-22 Get single sensor measurements
2021-05-30 Add sensor measurements visualisation, fix a few frontend bugs
2021-05-31 Add model design files, restructure visualisation
    [prosperIII.blend, prosperIII.obj, sensor.blend, sensor.obj]
2021-05-31 Sort sensor list
2021-06-03 Update deploy logic
    [sensor.blend, sensor.obj]
2021-06-13 Finish quick start section, add BOM
